QQQuyen/i2c_slave_power_temperature_sensor/README.md

# i2c-slave-power-temperature-sensor
Embedded power and temperature monitoring module using STM32F030.

## Features
- Voltage measurement (0-30V)
- Current measurement using shunt + INA180 (0-10A)
- Temperature measurement using NTC
- I2C slave interface
- Lookup table conversion

## System Architecture


## Hardware
**MCU**:
- STM32F030F4P6
  
**Sensors**
- Shunt resistor 0.01R
- INA180A1
- NTC 10K B3950
a_page-0001

## Firmware
For STM32 Cortex-M0 MCUs such as STM32F030, multi-channel ADC works best with:
- ADC Scan Mode
- DMA
  
Polling mode may produce unstable or incorrect channel readings during continuous conversion.
### Clock


### Pin config


## I2C Packet

| Byte | Description |
|---|---|
| 0-1 | Voltage |
| 2-3 | Current |
| 4-5 | Temperature |
| 6 | XOR checksum |

## PCB
- High current trace for 15A

  

- 2 Layer PCB
  
  

- Bottom GND plane
  
  

- 3D
  
  
   

## Test config

  

  .

  

  .

  

### Voltage measurement error <= 1%

### Current Measurement error

| Expected (A) | Min (A) | Max (A) | Error |
|---|---|---|---|
| 1 | 0.97 | 0.97 | 3.0% |
| 2 | 1.94 | 1.95 | 3.0% |
| 3 | 2.93 | 2.93 | 2.3% |
| 4 | 3.93 | 3.93 | 1.8% |
| 5 | 4.93 | 5.02 | 1.4% |
| 6 | 5.93 | 6.00 | 1.2% |
| 7 | 6.98 | 7.14 | 2.0% |
| 8 | 8.00 | 8.15 | 1.9% |
| 9 | 9.02 | 9.30 | 3.3% |
| 10 | 10.15 | 10.50 | 5.0% |



### Temperature measurement was not calibrated
## Future Improvements
### INA Output RC Filter
Add an RC low-pass filter at the INA180 output with cutoff frequency around 1 kHz (reduces PWM motor interference)


### Use multiple shunt resistors in parallel.
- current sharing
- lower shunt temperature
- improved current measurement stability
  


### High Current PCB Redesign


## Project Structure
├── PCB_Project/                               # PCB design files

├── PowerTempMeasurement_I2C_slave_STM32F030/ # Sensor module firmware

├── System_MasterI2C_STM32F103/               # I2C master test firmware

├── report_Vietnamese/                        # Vietnamese report

└── README.md
