QQQuyen/i2c_slave_power_temperature_sensor/PowerTempMeasurement_I2C_slave_STM32F030/Test_v10/Core/Src/main.c

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
/* Includes ------------------------------------------------------------------*/
#include "main.h"

/* USER CODE BEGIN Includes */
#include "i2c_slave.h"

/* USER CODE END Includes */

ADC_HandleTypeDef hadc;

DMA_HandleTypeDef hdma_adc;

I2C_HandleTypeDef hi2c1;

void SystemClock_Config(void);
static void MX_GPIO_Init(void);
static void MX_DMA_Init(void);
static void MX_ADC_Init(void);
static void MX_I2C1_Init(void);
/* USER CODE BEGIN 0 */

uint16_t ADC_buffer[4];

uint16_t Temp, Voltage,Current, Temp1, Voltage1,Current1;

const uint16_t temp_5bit[33] = {
		0,12994,10214,8710,7680,6893,6254,5711,5236,4812,4425,4068,3733,3415,3112,2819,2534,2254,1978,1702,1425,1143,856,558,246,-85,-443,-840,-1292,-1834,-2537,-3616,0
};

const uint16_t current_5bit[33] = {
		0,52,103,155,206,258,309,361,413,464,516,567,619,670,722,773,825,877,928,980,1031,1083,1134,1186,1238,1289,1341,1392,1444,1495,1547,1598,1650

 // giá trị 12-bit đã được scale sẵn
};

const uint16_t voltage_5bit[33] = {
		0,113,227,340,454,567,681,794,908,1021,1134,1248,1361,1475,1588,1702,1815,1928,2042,2155,2269,2382,2496,2609,2723,2836,2949,3063,3176,3290,3403,3517,3630
 // giá trị 12-bit đã được scale sẵn
};


uint16_t lookup_interpolated(const uint16_t *table, uint16_t index_12bit) {
    uint8_t i = index_12bit >> 7;        // Lấy 5 bit cao
    uint8_t f = index_12bit & 0b000001111111;       // Lấy 7 bit thấp

    uint16_t y0 = table[i];
    uint16_t y1 = table[i + 1];


    return y0 + (uint16_t)(((int32_t)(y1 - y0) * f) >> 7);
}
//Cách dùng


/* USER CODE END 0 */

/**
  * @brief  The application entry point.
  * @retval int
  */
int main(void)
{

  /* MCU Configuration--------------------------------------------------------*/

  /* Reset of all peripherals, Initializes the Flash interface and the Systick. */
  HAL_Init();

  /* Configure the system clock */
  SystemClock_Config();

  /* Initialize all configured peripherals */
  MX_GPIO_Init();
  MX_DMA_Init();
  MX_ADC_Init();
  HAL_ADCEx_Calibration_Start(&hadc);
  MX_I2C1_Init();
  /* USER CODE BEGIN 2 */
  if (HAL_I2C_EnableListen_IT(&hi2c1) != HAL_OK){
	  Error_Handler();
  }

  HAL_ADC_Start_DMA(&hadc, (uint32_t *)ADC_buffer, 4);

  /* USER CODE END 2 */

  /* Infinite loop */
  /* USER CODE BEGIN WHILE */
  while (1)
  {


	  uint16_t raw_v = ADC_buffer[0];
	  uint16_t raw_t = ADC_buffer[1];


	  uint32_t sum = 0;
	  for (int i = 0; i < 100; i++) {
		  for(int i = 0; i < 400; i++) {
		      __NOP();
		  }
		  sum += ADC_buffer[2];
	  }
	  uint16_t raw_i = (uint16_t)(sum / 100);

	  // scale trước hoặc sau lookup đều được (tùy logic bạn)
	  uint16_t scaled_v = (uint32_t)raw_v * 1489/43*44  /ADC_buffer[3];


	  uint16_t scaled_t = (uint32_t)raw_t * 1489 / ADC_buffer[3];
	  uint16_t scaled_i = (uint32_t)raw_i * 1489/14*13/ ADC_buffer[3];


	  Voltage = lookup_interpolated(voltage_5bit, scaled_v);
	  Temp    = lookup_interpolated(temp_5bit, scaled_t);
	  Current = lookup_interpolated(current_5bit, scaled_i);

	  static uint8_t myData[7];

	   myData[0] = Voltage >> 8;
	   myData[1] = Voltage & 0xFF;
	   myData[2] = Current >> 8;
	   myData[3] = Current & 0xFF;
	   myData[4] = Temp >> 8;
	   myData[5] = Temp & 0xFF;

	   myData[6] = myData[0]^myData[1]^myData[2]^myData[3]^myData[4]^myData[5];

	   I2C_SetTxData(myData);
	   HAL_Delay(10);
    /* USER CODE END WHILE */

    /* USER CODE BEGIN 3 */
  }
  /* USER CODE END 3 */
}

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
