QQQuyen/i2c_slave_power_temperature_sensor/PowerTempMeasurement_I2C_slave_STM32F030/Test_v10/Test_v10.ioc

Mcu.UserName=STM32F030F4Px
PA0.Signal=GPIO_Input
PA1.Signal=GPIO_Input
PA10.Signal=I2C1_SDA
PA2.Signal=ADC_IN2
PA3.Signal=ADC_IN3
PA4.Signal=ADC_IN4
PA9.Signal=I2C1_SCL
