QQQuyen/i2c_slave_power_temperature_sensor/System_MasterI2C_STM32F103/Test_v8/Core/Inc/lcd_i2c.h

/*
 * lcd_i2c.h
 *
 *  Created on: Mar 18, 2026
 *      Author: MyLaptop
 */

#ifndef __LCD_I2C_H
#define __LCD_I2C_H

#include "stm32f1xx_hal.h"

void lcd_init(void);
void lcd_send_cmd(char cmd);
void lcd_send_data(char data);
void lcd_send_string(char *str);
void lcd_clear(void);
void lcd_put_cur(int row, int col);

#endif
