QQQuyen/i2c_slave_power_temperature_sensor/(commit log)

2026-05-16 Enhance README with comprehensive project details
    Expanded README with detailed features, hardware, firmware, I2C packet structure, PCB design, test configuration, and future improvements.
2026-05-16 Add STM32 I2C slave sensor project
2026-05-17 Update current measurement specification in README
