QQQuyen/i2c_slave_power_temperature_sensor/(notices)

Notices in the files:
PowerTempMeasurement_I2C_slave_STM32F030/Test_v10/Core/Src/main.c:
Copyright (c) 2026 STMicroelectronics.
All rights reserved.
This software is licensed under terms that can be found in the LICENSE file
